lindoran/HB63C09/Docs and Schematics/DEV Board REV 3 Memory Map.ods

 | ROM / RAM Configuration
Addreses | 64K Main Address Space
C000-FFFF | Upper Fixed RAM 16K Legacy Physical ROM Space | 20K System Rom –>
B000-BFFF | Upper Fixed RAM 4K Expanded Legacy ROM Space
A000-AFFF | Device Address Space for MCU 4K | 4K System Address Space –>
8000-9FFF | Lower Fixed 8K of Fixed Lower Ram Area
4000-7FFF | Lower Fixed 16K of Fixed Lower Ram Area | 40K Contiguous (with lower bank) –>
0000-3FFF | Memory Bank Window, set by bank register (16K)
 | 128K RAM Chip Layout | BANK SELECT BINARY | (HEX/DEC)
1C000-1FFFF | Bank 7 (16K) | b111 | 7
18000-1BFFF | Bank 6 (16K) | b110 | 6
14000-17FFF | Bank 5 (16K) | b101 | 5
10000-13FFF | Bank 4 (16K) | b100 | 4
C000-FFFF | Bank 3 (16K) | b011 | 3
B000-BFFF | Bank 2 (4K) Fixed RAM Expanded ROM Space “Shadow” (3000-3FFF in bank) | b010 | 2
A000-AFFF | Bank 2 (4K) Bank 2 Free RAM Area “Behind” IO Space (2000-2FFF in bank) | b010 | 2
8000-9FFF | Bank 2 (8K) Lower Ram Area Top 8K “Shadow” (0000-1FFF in bank) | b010 | 2
4000-7FFF | Bank 1 (16K) Fixed Lower Ram Area Bottom 16K | b001 | 1
0000-3FFF | Bank 0 (16K) bottom 16K of ram chip. Boots with this selected. | b000 | 0
