lindoran/HB63C09/Design Files/REV 4.2 (Current)/BOM HC Logic.ods

HB6309M-HC
Mouser # | Mfr. # | Manufacturer | Customer # | Description | RoHS | Lifecycle | Order Qty. | Price (USD) | Ext.: (USD)
594-K104K15X7RF53L2 | K104K15X7RF53L2 | Vishay |  | Multilayer Ceramic Capacitors MLCC - Leaded 0.1uF 50volts 10% X7R 2.5mm LS | RoHS Compliant By Exemption |  | 16 | $0.12 | $1.92
667-EEA-GA1A101H | EEA-GA1A101H | Panasonic |  | Aluminum Electrolytic Capacitors - Radial Leaded 10volt 100uF 6.3X7mm L/S=2.5mm Ammo STR | RoHS Compliant |  | 3 | $0.31 | $0.93
512-1N4148 | 1N4148 | onsemi |  | Small Signal Switching Diodes 100V Io/200mA BULK | RoHS Compliant By Exemption |  | 1 | $0.10 | $0.10
511-1N5817 | 1N5817 | STMicroelectronics |  | Schottky Diodes & Rectifiers Vr/20V Io/1A BULK | RoHS Compliant By Exemption |  | 1 | $0.36 | $0.36
941-C5SMFGJFCV0Y0792 | C5SMF-GJF-CV0Y0792 | Cree LED |  | Standard LEDs - Through Hole Green Oval LED | RoHS Compliant |  | 1 | $0.23 | $0.23
941-C5SMFBJECR0U0452 | C5SMF-BJE-CR0U0452 | Cree LED |  | Standard LEDs - Through Hole Blue Oval LED | RoHS Compliant |  | 1 | $0.23 | $0.23
603-CFR-25JB-1K0 | CFR-25JB-1K0 | YAGEO |  | Carbon Film Resistors - Through Hole 1 kOhms 250 mW 5 % | RoHS Compliant |  | 3 | $0.10 | $0.30
708-CF14JT10K0 | CF14JT10K0 | SEI Stackpole |  | Carbon Film Resistors - Through Hole 10KOhms 1/4W 5% Std Carbon | RoHS Compliant | New At Mouser | 15 | $0.022 | $0.33
603-CFR-25JR-52-39R | CFR-25JR-52-39R | YAGEO |  | Carbon Film Resistors - Through Hole 1/4W 39 Ohm 5% | RoHS Compliant |  | 2 | $0.10 | $0.20
603-CFR-25JB-52-4K7 | CFR-25JB-52-4K7 | YAGEO |  | Carbon Film Resistors - Through Hole 1/4W 4.7K Ohm 5% | RoHS Compliant |  | 2 | $0.10 | $0.20
652-4609X-1LF-4.7K | 4609X-101-472LF | Bourns |  | Resistor Networks & Arrays 4.7K OHM 9 PIN 2% LOW C-SI | RoHS Compliant By Exemption |  | 3 | $0.48 | $1.44
652-4605X-AP1-472LF | 4605X-AP1-472LF | Bourns |  | Resistor Networks & Arrays THICK FILM 2% 4.7K CONFRML SIP 5 | RoHS Compliant By Exemption |  | 1 | $0.45 | $0.45
652-4609X-1LF-10K | 4609X-101-103LF | Bourns |  | Resistor Networks & Arrays 9pins 10Kohms Bussed | RoHS Compliant By Exemption |  | 1 | $0.47 | $0.47
913-AS6C1008-55PCN | AS6C1008-55PCN | Alliance Memory |  | SRAM LP SRAM, 1Mb, 128K x 8, 2.7 - 5.5V, 32pin PDIP, 55ns, Commercial Temp - Tube | RoHS Compliant |  | 1 | $5.11 | $5.11
556-ATMEGA32A-PU | ATMEGA32A-PU | Microchip |  | 8-bit Microcontrollers - MCU 32KB In-system Flash 2.7V - 5.5V | RoHS Compliant | NRND | 1 | $4.89 | $4.89
774-MXO45HS-3C-20.0 | MXO45HS-3C-20M0000 | CTS |  | Standard Clock Oscillators 20MHz 50ppm 8Pin DIP/STD | RoHS Compliant |  | 1 | $3.25 | $3.25
595-CD74HC243EE4 | CD74HC243EE4 | Texas Instruments |  | Bus Transceivers Hi-Sp CMOS Quad Bus Trncvr W/3St Otp | RoHS Compliant |  | 1 | $0.87 | $0.87
595-CD74HC139E | CD74HC139E | Texas Instruments |  | Encoders, Decoders, Multiplexers & Demultiplexers High Speed CMOS Dual 2-to-4 Line | RoHS Compliant |  | 1 | $0.79 | $0.79
595-CD74HC138E | CD74HC138E | Texas Instruments |  | Encoders, Decoders, Multiplexers & Demultiplexers Line Decoder | RoHS Compliant |  | 1 | $1.16 | $1.16
595-CD74HC125EE4 | CD74HC125EE4 | Texas Instruments |  | Buffers & Line Drivers Hi-Sp CMOS Lgc Quad Buff W/3-St Otpt | RoHS Compliant |  | 1 | $0.87 | $0.87
595-CD74HC00EE4 | CD74HC00EE4 | Texas Instruments |  | Logic Gates Hi-Speed CMOS Logic Quad 2-Inp NAND Gate ALT 595-CD74HC00E | RoHS Compliant |  | 1 | $1.43 | $1.43
757-TC74HC14AP(F,M) | TC74HC14APF | Toshiba |  | Inverters Hex Schmitt Inverter | RoHS Compliant |  | 1 | $0.45 | $0.45
595-CD74HC173E | CD74HC173E | Texas Instruments |  | Flip Flops Quad HS CMOS | RoHS Compliant |  | 1 | $0.53 | $0.53
595-SN74HC245N | SN74HC245N | Texas Instruments |  | Bus Transceivers Tri-State Octal Bus | RoHS Compliant |  | 1 | $0.81 | $0.81
855-M20-7832046 | M20-7832046 | Harwin |  | Headers & Wire Housings 20+20 DIL VERTICAL SOCKET TIN | RoHS Compliant |  | 1 | $3.96 | $3.96
179-TS026660BK100SCR | TS02-66-60-BK-100-SCR-D | Same Sky |  | Tactile Switches 6 x 6 mm, 6 mm Act Height, 100 gf, Black, Short Crimped, Through Hole, SPST, | RoHS Compliant |  | 1 | $0.10 | $0.10
710-613006143121 | 613006143121 | Wurth Elektronik |  | Headers & Wire Housings WR-PHD 2.54mm Socket Header 6 pins | RoHS Compliant |  | 2 | $0.65 | $1.30
538-22-28-5020 | 22-28-5020 | Molex |  | Headers & Wire Housings 2.54MM HDR VT 2P 240/135 SN | RoHS Compliant |  | 1 | $0.11 | $0.11
437-9991931006 | 999-19-310-06 | Preci-dip |  | Headers & Wire Housings | RoHS Compliant |  | 1 | $0.29 | $0.29
306-B2BXH2TV4LFSN | B2B-XH-2-TV4(LF)(SN) | JST |  | Headers & Wire Housings XA HEADER ON RADIAL-TAPE (TOP TYPE) | RoHS Compliant | New At Mouser | 1 | $0.28 | $0.28
649-75869-331LF | 75869-331LF | Amphenol |  | Headers & Wire Housings 6P DR VERT SHRD HDR .38 GOLD | RoHS Compliant |  | 1 | $0.54 | $0.54
737-ICS-640-T | ICS-640-T | Adam Tech |  | IC & Component Sockets 40P / .600" | RoHS Compliant | New At Mouser | 2 | $0.42 | $0.84
737-ICS-632-T | ICS-632-T | Adam Tech |  | IC & Component Sockets 32P / .600" | RoHS Compliant | New At Mouser | 1 | $0.34 | $0.34
571-1-2199298-3 | 1-2199298-3 | TE Connectivity |  | IC & Component Sockets 14P DIP SKT 300 CL LADDER | RoHS Compliant |  | 3 | $0.20 | $0.60
571-1-2199298-4 | 1-2199298-4 | TE Connectivity |  | IC & Component Sockets 16P DIP SKT 300 CL LADDER | RoHS Compliant |  | 2 | $0.23 | $0.46
PARTS NOT ON MOUSER:
 | HD63C09P / HD63C09RP | Hitachi |  | 6309 CMOS CPU INTERNAL CLOCK VERSION*
 | HW-125 | Varies |  | SD CARD MODULE WITH 5V LEVELS SHIFTER
 | FTDI ADAPTER | HiLetgo |  | FT232RL Mini USB to TTL Serial Converter Adapter Module 3.3V/5.5V
 | USBTiny | Varies |  | USBtinyISP Programmer for Arduino Boot Loader
 |  |  |  | * There is also a 63C09E, EP & and ECP (in PLCC). These are the EXTERNAL clock versions.
 |  |  |  | They WILL NOT work without major circuit modification and the addition of 1 – 2 chips.
 |  |  |  | This project is only designed for the HD63C09 (NO E) which often can be found as HD63C09P, or
 |  |  |  | HD63C09RP. There is also a NMOS version which is commonly found with prefix of HD63B09
 |  |  |  | or HD6309, these have not been tested with the board but may work with a 12MHz crystal.
 |  |  |  | IN ALL CASES, a 6809 will not work, as 6309 only instructions are used to boot the computer, as
 |  |  |  | well as the 6809 has significantly different (less lax) MRDY characteristics.
