lindoran/HB63C09/Docs and Schematics/Schematic_HB68C09-REV-4.1-10x10-SBC-63C09M_2024-10-23.pdf

Vss 16 DQ3 17 DQ4 18 DQ5 19 DQ6 20 DQ7 21 CE# 22 A10 23 OE# 24 A11 25 A9 26 A8 27 A13 28 WE# 29 CE2 30 A15 31 Vcc 32

# DA0d7d6

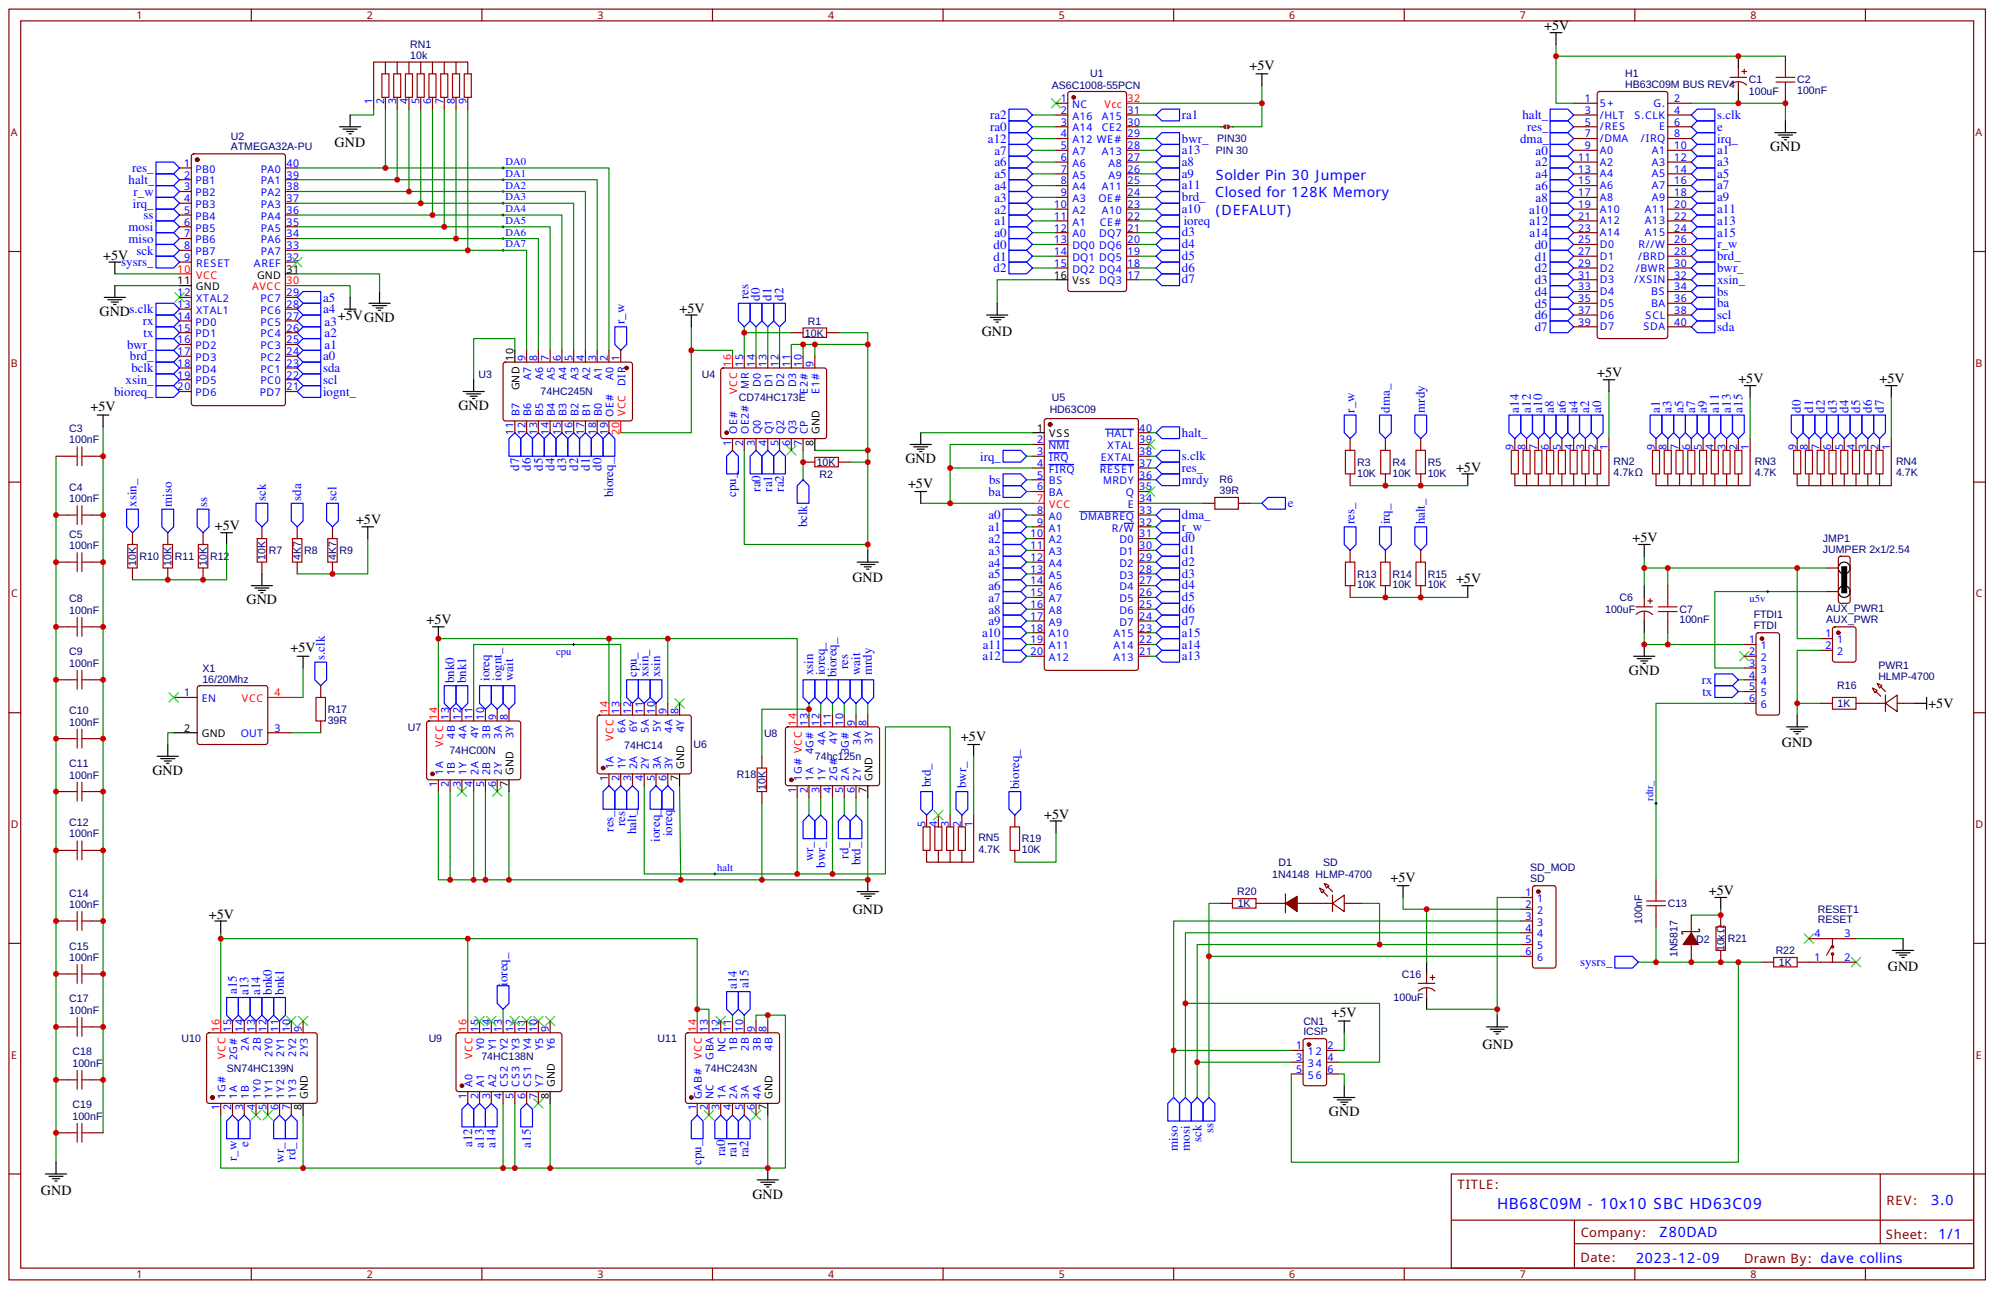
[picture p21: page 1]

Drawn By : dave collins
