lindoran/HB63C09/Docs and Schematics/Schematic_HB68C09-REV-4-10x10-SBC-63C09_2024-08-01.pdf

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

# DA0d7d6

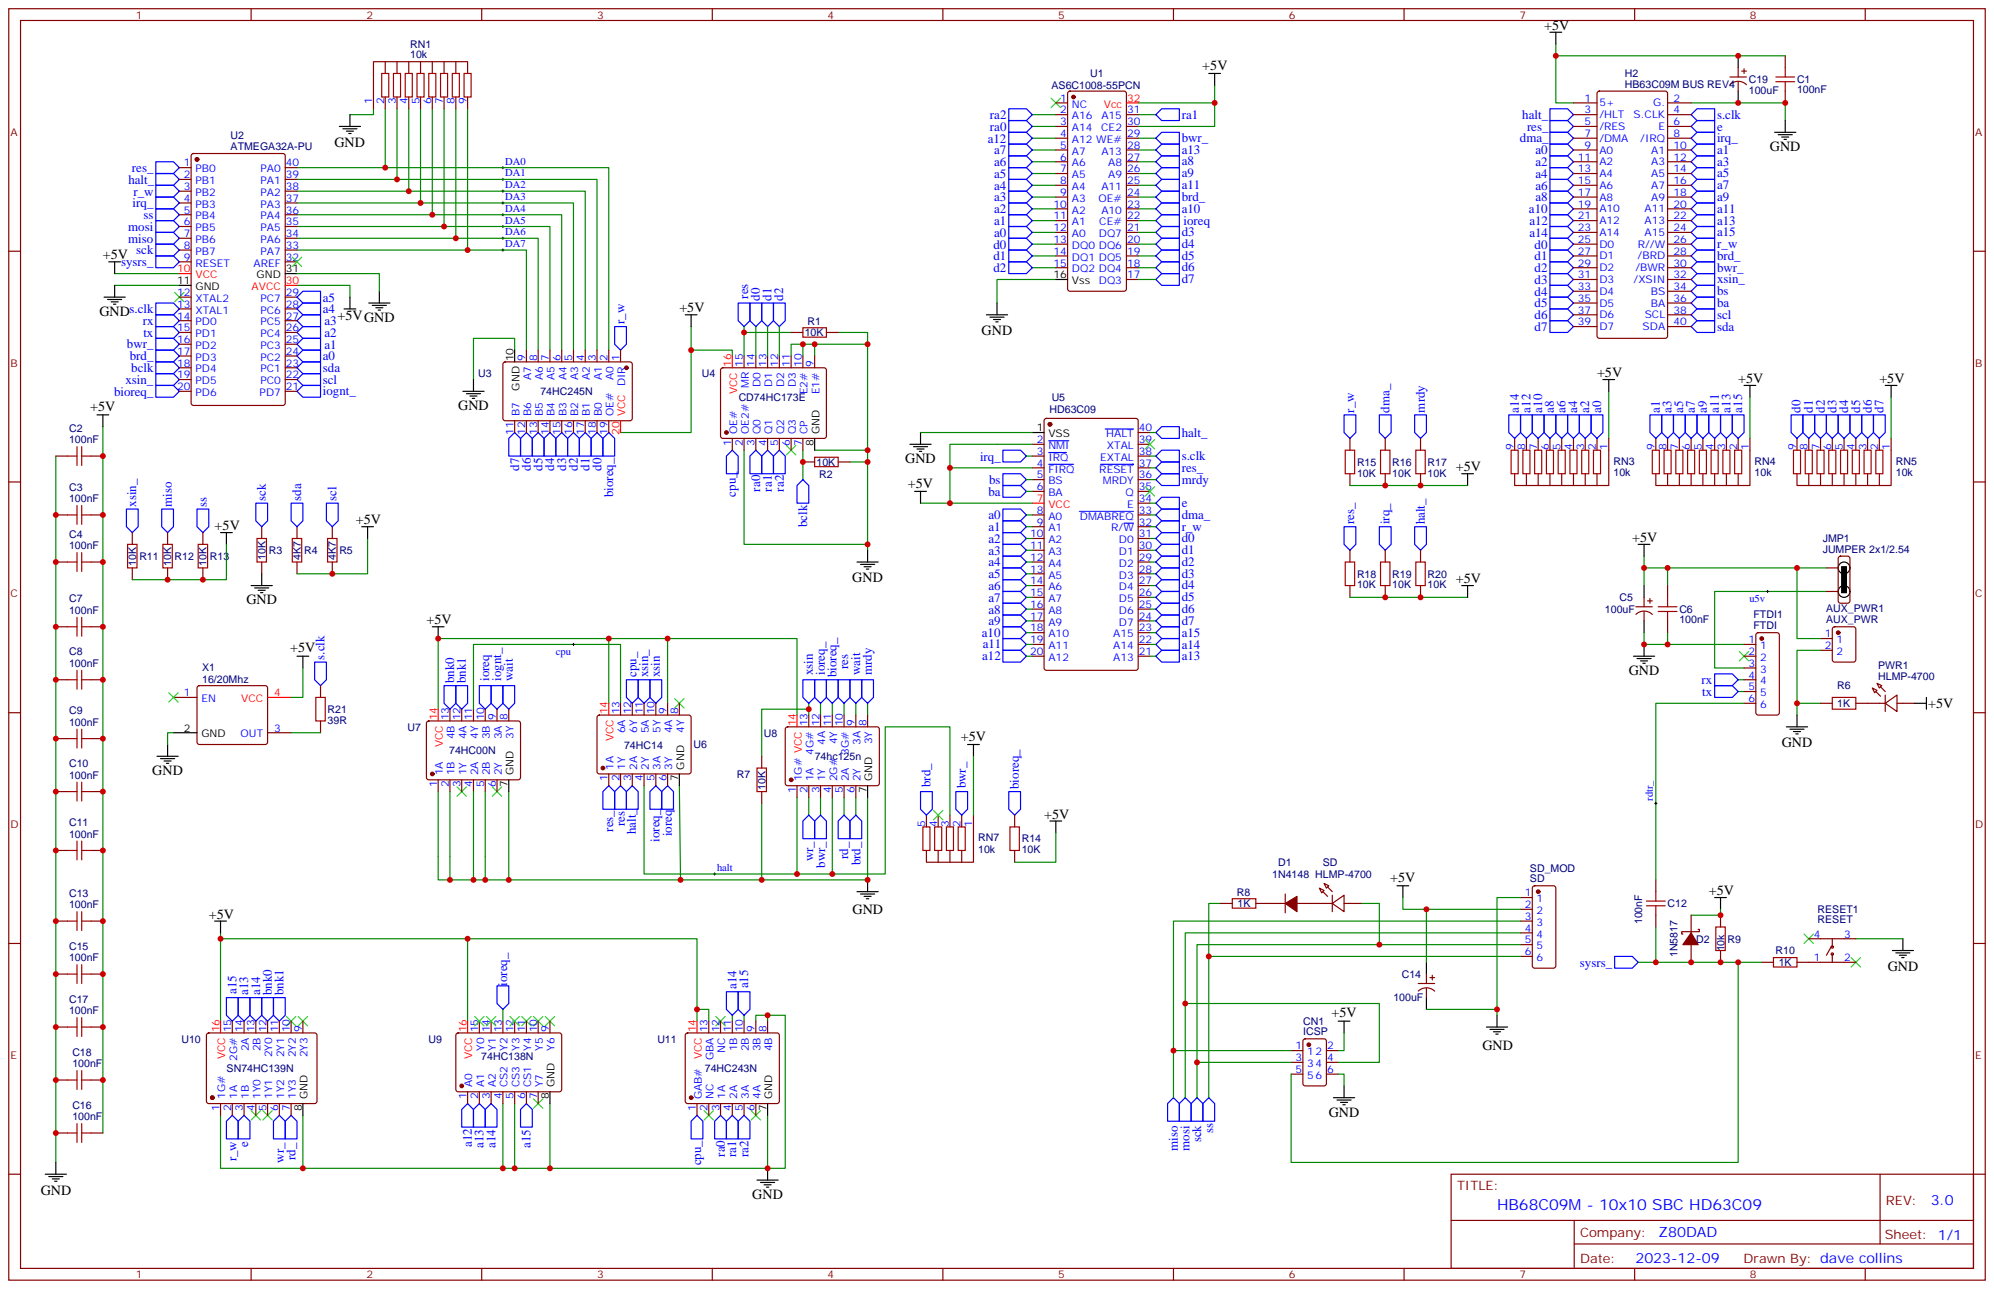
[picture p22: page 1]

35 MRDY 36 RESET 37 EXTAL 38 XTAL 39 HALT 40

Drawn By: dave collins
