lindoran/HB63C09/(commit log)

2024-01-27 Arduino Firmware
2024-01-29 update url to hackaday.io was pointing to wrong project
    [HB63C09M.ino]
2024-02-10 Updated firmware to work with mods: added 2 more address lines, added reset (active high) line to address latch, added active low logic to xsin line is now _xsin and should be considered open collect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
    [HB63C09M.ino]
2024-02-12 clarity and bug fixes
    [blockcopy.asm]
2024-02-29 Working self stageing
2024-02-29 working stageing
2024-04-07 Working SD Baseline and Rom Firmware
    [DEV Board REV 3 Memory Map.ods]
2024-04-11 Added back UART init for testing
2024-04-12 Arduino Internal EEPROM now stores Staging details
2024-04-12 Changed EEPROM Checksum / comment blockcopy.h
    The EEPROM checksum would improperly calculate to a sucsessfull
    check if the data was all 0xFF. this was fixed by setting the
    checksum to take the 1's compliment.
    [HB63C09M.ino, blockcopy.h]
2024-08-01 Add files via upload
    update schematics
2024-10-05 backup to git-last commit before prerelease gerbers
    [DEV Board REV 3 Memory Map.ods, IO Controller device tables.ods]
2024-10-21 Final Commit before Board release
2024-10-24 4.2 Release - Gerbers and production files!
    [BOM (TESTED HC LOGIC CHIPS).ods, BOM (UNTESTED AHC LOGIC CHIPS).ods]
2024-11-05 Very Large documentation update, Plus 4.2 Vfyd
    [BOM (TESTED HC LOGIC CHIPS).ods, BOM (UNTESTED AHC LOGIC CHIPS).ods, BOM AHC Logic.ods, BOM Digi-Key AHC Logic.ods, BOM HC Logic (Depreciated).ods, BOM Mouser AHC Logic.ods]
2024-11-05 Fix typos and omissions in documentation
    [BOM Digi-Key AHC Logic.ods]
2024-11-26 mon09 and arduino sketch enhancements
2024-12-28 Rolled back BOM to HC logic to resove a latancey issue
    [BOM AHC Logic.ods, BOM Digi-Key AHC Logic (reviesed).ods, BOM HC Logic.ods, BOM Mouser AHC Logic.ods]
2025-01-04 Removed ILLOP handler Fixes bug in BIOS.BIN
    [mon09v37.asm]
2025-02-20 Added support for timer based interupts, documents forthcomeing
2025-03-27 Big changes: 256 Byte Sectoring, systic timer
2025-05-08 Remove broken flextools submodule
    [BOM HC Logic.ods, IO Controller device tables.ods]
2025-06-09 update print(), build more functions
2025-06-09 forgot to save work, committing print() updates
